treelinemike/binary-counter/README.md

# binary-counter
AVR binary counter for LED display - used to check synchronization of stereo camera systems
