treelinemike/binary-counter/pcb/stereo-sync-pcb-bom.xlsx

Identifier | Qty. | Description | DigiKey Part | Mfgr. | Mfgr. Part | Package | Unit Price | Extended | Notes
IC1 | 1 | MCU | ATXMEGA256A3BU-AU-ND (https://www.digikey.com/product-detail/en/microchip-technology/ATXMEGA256A3BU-AU/ATXMEGA256A3BU-AU-ND/3046475) | Microchip | ATXMEGA256A3BU-AU | 64-TQFP (14x14) | $7.20 | $7.20
J3 | 1 | Shrouded keyed header | 1175-1864-ND (https://www.digikey.com/product-detail/en/cnc-tech/3020-06-0300-00/1175-1864-ND/3883217) | CNC Tech | 3020-06-0300-00 |  | 0.48 | $0.48
J2 | 0 | Right angle header, no shroud | SAM9026-ND (https://www.digikey.com/product-detail/en/samtec-inc/TSM-103-01-L-DH/SAM9026-ND/2501234) | Samtec | TSM-103-01-L-DH |  | $0.88 | $0.00
J2 | 0 | Programming header | 609-6366-ND (https://www.digikey.com/product-detail/en/amphenol-icc-fci/54202-G3003LF/609-6366-ND/4242782) | Amphenol / FCI | 54202-G3003LF |  | $0.36 | $0.00
D1-D8 | 8 | Surface Mount LED | 160-1405-1-ND (https://www.digikey.com/products/en?keywords=160-1405-1-ND) | Lite-On | LTST-C150KRKT | 1206 | $0.38 | $3.04
 | 1 | Battery Holder | BH2AAA-W-ND (https://www.digikey.com/product-detail/en/mpd-memory-protection-devices/BH2AAAW/BH2AAA-W-ND/32052) | MPD (http://www.memoryprotectiondevices.com/datasheets/BH2AAAW-datasheet.pdf) | BH2AAAW |  | $3.20 | $3.20 | use #2-56 button head cap screws (head 0.006" protrusion)
 | 1 | Female connector housing for battery | WM2900-ND (https://www.digikey.com/products/en?keywords=WM2900-ND) | Molex | 50-57-9402 |  | $0.27 | $0.27
J1 | 1 | Surface mount connector receptacle | WM1340-ND (https://www.digikey.com/products/en?keywords=WM1340-ND) | Molex | 15-91-2025 |  | $2.74 | $2.74
 | 1 | Surface mount connector for UART | WM1341-ND (https://www.digikey.com/products/en?keywords=15-91-2035) | Molex | 15-91-2035 |  | $3.60 | $3.60
XTAL1 | 1 | Crystal Oscillator | 887-1274-1-ND (https://www.digikey.com/product-detail/en/txc-corporation/9C-16.000MEEJ-T/887-1274-1-ND/2207856) | TXC | 9C-16.000MEEJ-T |  | $0.59 | $0.59
C4-C5 | 2 | Crystal load capacitors | 399-9344-1-ND (https://www.digikey.com/product-detail/en/kemet/C1206C309D5GACTU/399-9344-1-ND/3522862) | KEMET | C1206C309D5GACTU | 1206 | $0.47 | $0.94 | Large package for easy soldering; MCU XTAL1&2 pin parasitic caps = 5.2pF and 6.8pF. Need 6pF additional to get to 18pF, so 3pF on each terminal. Doesn't account for trace capacitance.
SW1 | 1 | Power Switch | 401-1999-1-ND (https://www.digikey.com/product-detail/en/c-k/JS102011SAQN/401-1999-1-ND/1640114) | C&K | JS102011SAQN |  | $0.56 | $0.56 | 300mA max, should be OK with 8x20mA LEDs and MCU
R1 | 1 | Pull-up resistor, 100K | 311-100KFRCT-ND (https://www.digikey.com/product-detail/en/yageo/RC1206FR-07100KL/311-100KFRCT-ND/731439) | Yageo | RC1206FR-07100KL | 1206 | $0.10 | $0.10
C1,C2 | 2 | Filter capacitor, 0.1uF | 311-1179-1-ND (https://www.digikey.com/product-detail/en/yageo/CC1206KRX7R9BB104/311-1179-1-ND/303089) | Yageo | CC1206KRX7R9BB104 | 1206 | $0.19 | $0.38 | 27 ohm should sink ~17mA max from LED into micro; max spec on Xmega pins is 20mA (25mA absolute max), effective 30ohm impedance to sink per datasheet graph, LED drops ~2.0V for 10-25mA, assuming max supply 3.0V, may sink 21mA transiently with new batteries if each provides 1.6V at load current (unlikely)
C3 | 1 | Filter capacitor, 10uF | 311-1376-1-ND (https://www.digikey.com/product-detail/en/yageo/CC1206ZKY5V7BB106/311-1376-1-ND/2103160) | Yageo | CC1206ZKY5V7BB106 | 1206 | $0.30 | $0.30
R2-R9 | 8 | Resistor, 27R0 | 311-27ERCT-ND (https://www.digikey.com/product-detail/en/yageo/RC1206JR-0727RL/311-27ERCT-ND/732208) | Yageo | RC1206JR-0727RL | 1206 | $0.10 | $0.80
TP1-3 | 3 | Test Point | 36-5000-ND (https://www.digikey.com/product-detail/en/keystone-electronics/5000/36-5000-ND/255326) | Keystone | 5000 |  | $0.35 | $1.05
 | 1 | PCB, 3 copies |  | Oshpark (Super Swift) (https://docs.oshpark.com/services/super-swift/) |  |  | $25.00 | $25.00
 | 0 | PCB |  | Advanced Circuits (https://www.4pcb.com/pcb-prototype-2-4-layer-boards-specials.html) |  |  | $33.00 | $0.00
 |  |  |  |  |  |  | Total | $50.25
