treelinemike/binary-counter/pcb/binary_counter.kicad_pcb

## KiCad design pcb/binary_counter.kicad_pcb (2019-06-19)

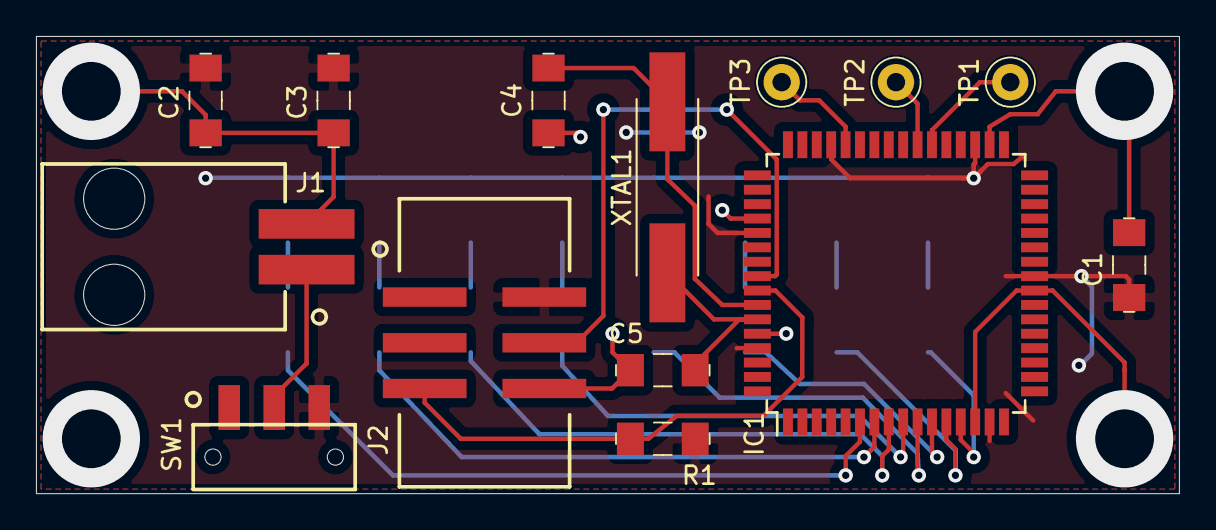
[picture p1: board binary_counter.kicad_pcb from above]

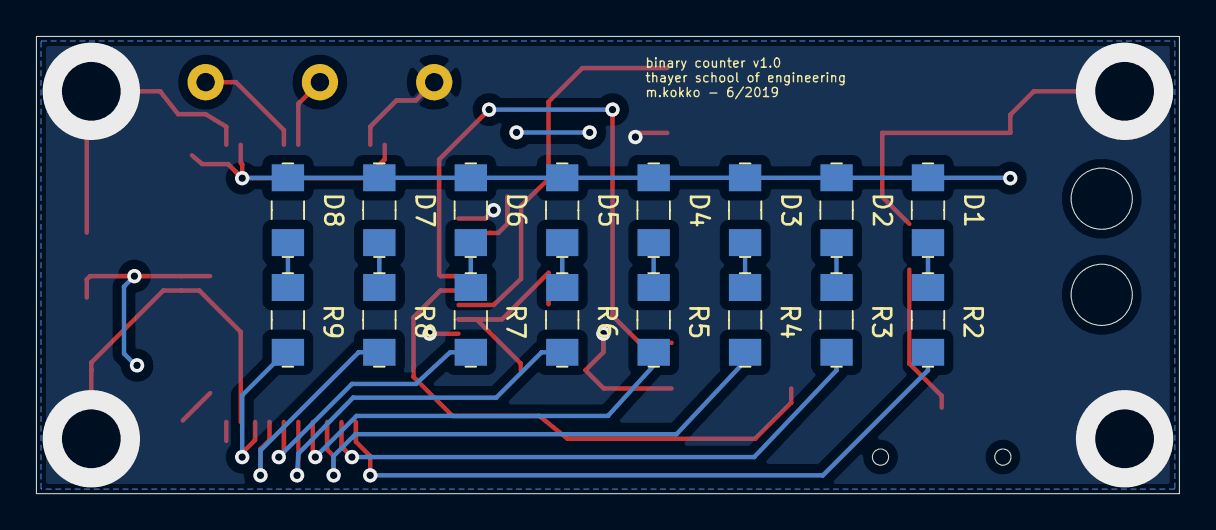
[picture p2: board binary_counter.kicad_pcb from below]

Board: 2 copper layers, 63.5 x 25.4 mm, 30 parts (16 on the bottom side), 25 nets.

Parts:
C1, C2: 0.1uF; 1206
C3: 10uF; 1206
C4, C5: 3pF; 1206
D1, D2, D3, D4, D5, D6, D7, D8: LTST-C150KRKT; 1206
IC1: ATXMEGA256A3BU-A; TQFP-64_14x14mm_P0.8mm
J1: Conn_01x02_Male; Molex_15_91_2025
J2: CONN_02X03; prog_header
R1: 100K; 1206
R2, R3, R4, R5, R6, R7, R8, R9: 47R0; 1206
SW1: SW_SPDT; SWITCH_CK_JS102011SAQN
TP1, TP2, TP3: 5000; Test_Point_D1.02mm
XTAL1: 16MHZ; TXC_xtal

Connections:
+3V0: C1.1, C2.1, C3.1, D1.1, D2.1, D3.1, D4.1, D5.1, D6.1, D7.1, D8.1, IC1.15, IC1.25, IC1.35, IC1.45, IC1.53, IC1.61, J2.2, R1.2, SW1.3
GND: C1.2, C2.2, C3.2, C4.1, C5.1, IC1.14, IC1.24, IC1.34, IC1.44, IC1.52, IC1.60, J1.2, J2.6, TP3.1
unnamed: C4.2, IC1.58, XTAL1.1
unnamed: C5.2, IC1.59, XTAL1.2
unnamed: D1.2, R2.1
unnamed: D2.2, R3.1
unnamed: D3.2, R4.1
unnamed: D4.2, R5.1
unnamed: D5.2, R6.1
unnamed: D6.2, R7.1
unnamed: D7.2, R8.1
unnamed: D8.2, R9.1
unnamed: IC1.6, R2.2
unnamed: IC1.7, R3.2
unnamed: IC1.8, R4.2
unnamed: IC1.9, R5.2
unnamed: IC1.10, R6.2
unnamed: IC1.11, R7.2
unnamed: IC1.12, R8.2
unnamed: IC1.13, R9.2
unnamed: IC1.38, TP1.1
unnamed: IC1.39, TP2.1
unnamed: IC1.56, J2.4
unnamed: IC1.57, J2.5, R1.1
unnamed: J1.1, SW1.2
