treelinemike/binary-counter/(commit log)

2019-05-24 switched to displaying inverted count since hardware configuration sinks LEDs to MCU
2019-06-17 added kicad files, copied from orthosensor project
    [binary_counter.kicad_pcb, binary_counter.sch, stereo-sync-pcb-bom.xlsx]
2019-06-17 started revising schematic and specifying components.
    [binary_counter.sch, stereo-sync-pcb-bom.xlsx]
2019-06-18 continued adding footprints, etc.
    [binary_counter.sch, stereo-sync-pcb-bom.xlsx]
2019-06-18 finished adding footprints and started laying out board
    [binary_counter.sch, stereo-sync-pcb-bom.xlsx]
2019-06-18 continued PCB layout, all components in appropriate locations now
    [binary_counter.kicad_pcb, binary_counter.sch, stereo-sync-pcb-bom.xlsx]
2019-06-18 changed pcb vendor to oshpark
    [stereo-sync-pcb-bom.xlsx]
2019-06-19 added schematic notes, changed R2-9 to 27R0 to accomodate I/O pin input impedance
    [binary_counter.sch, stereo-sync-pcb-bom.xlsx]
2019-06-19 finished first pass at pcb layout
    [binary_counter.kicad_pcb]
2019-06-19 tweaked pcb layout, passes default drc
    [binary_counter.kicad_pcb]
2019-06-19 updated drcs
    [binary_counter.kicad_pcb]
2019-06-19 added gerbers
    [binary_counter-B_Cu.gbr, binary_counter-B_Mask.gbr, binary_counter-B_SilkS.gbr, binary_counter-Edge_Cuts.gbr, binary_counter-F_Cu.gbr, binary_counter-F_Mask.gbr, binary_counter-F_SilkS.gbr, binary_counter.drl]
2019-06-19 regenerated gerbers without tenting, ordered from oshpark
    [binary_counter-B_Cu.gbr, binary_counter-B_Mask.gbr, binary_counter-B_SilkS.gbr, binary_counter-Edge_Cuts.gbr, binary_counter-F_Cu.gbr, binary_counter-F_Mask.gbr, binary_counter-F_SilkS.gbr, binary_counter.drl]
2019-06-19 regenerated gerbers without tenting, ordered from oshpark - included gerber zip file
2019-06-27 corrected LED port for PCB, added info on programming fuse byte 4 to disable JTAG (enabled by default), and deleted an extraneous PDF
2019-06-28 changed frame rate to 59.94Hz
